nphylxs/fpga-guitar-pedal/docs/guitar-wiring-guide.png

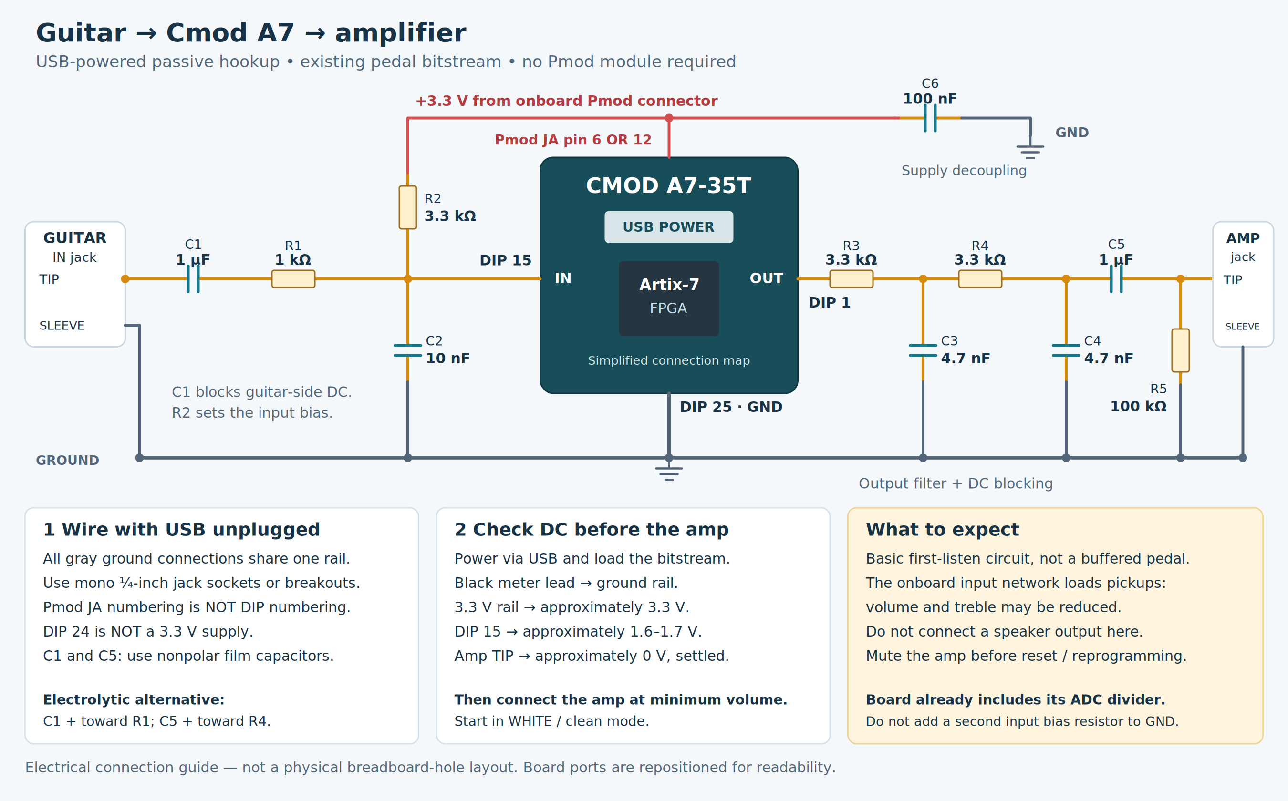
docs/guitar-wiring-guide.png
