nphylxs/fpga-guitar-pedal/docs/guitar-wiring-updated.png

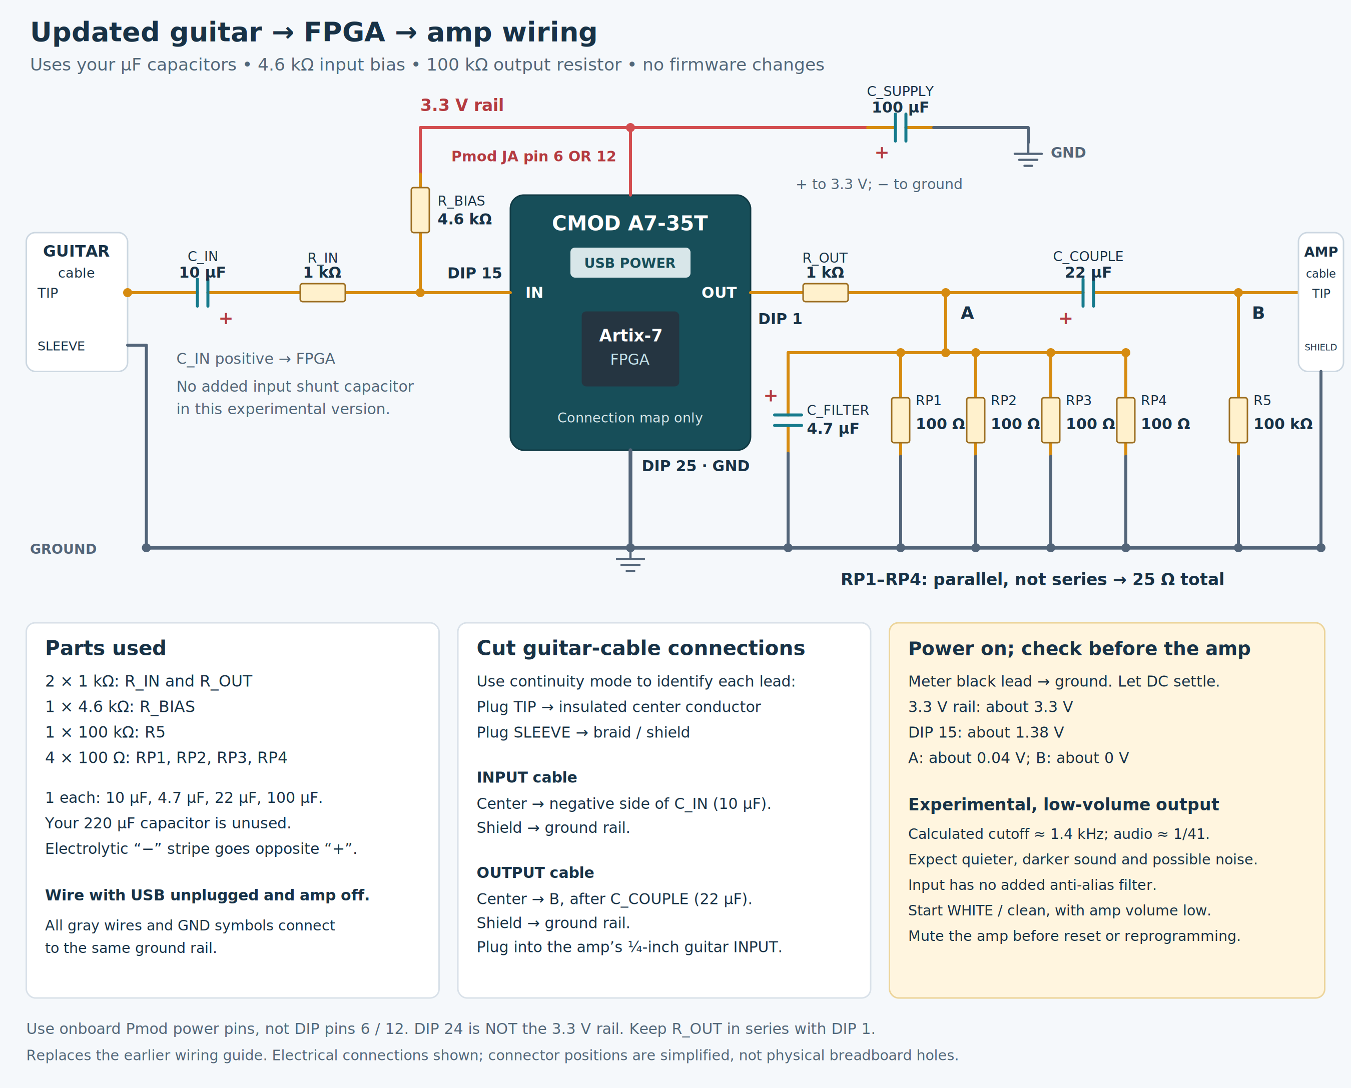
docs/guitar-wiring-updated.png
