nphylxs/fpga-guitar-pedal/rtl/fx_overdrive_asym.sv

module fx_overdrive_asym (
  input logic clk, rst, in_valid, enable,
  input logic signed [15:0] audio_in,
  input logic [7:0] drive,
  input logic [15:0] tone_alpha,
  output logic signed [15:0] audio_out,
  output logic out_valid
);
  import audio_math_pkg::*;
  function automatic logic signed [15:0] clip_lut(input logic [7:0] addr);
    case(addr)
      8'd0: clip_lut = 16'shc000;
      8'd1: clip_lut = 16'shc000;
      8'd2: clip_lut = 16'shc000;
      8'd3: clip_lut = 16'shc000;
      8'd4: clip_lut = 16'shc000;
      8'd5: clip_lut = 16'shc000;
      8'd6: clip_lut = 16'shc000;
      8'd7: clip_lut = 16'shc000;
      8'd8: clip_lut = 16'shc000;
      8'd9: clip_lut = 16'shc000;
      8'd10: clip_lut = 16'shc000;
      8'd11: clip_lut = 16'shc000;
      8'd12: clip_lut = 16'shc000;
      8'd13: clip_lut = 16'shc000;
      8'd14: clip_lut = 16'shc000;
      8'd15: clip_lut = 16'shc000;
      8'd16: clip_lut = 16'shc000;
      8'd17: clip_lut = 16'shc000;
      8'd18: clip_lut = 16'shc000;
      8'd19: clip_lut = 16'shc000;
      8'd20: clip_lut = 16'shc000;
      8'd21: clip_lut = 16'shc000;
      8'd22: clip_lut = 16'shc000;
      8'd23: clip_lut = 16'shc000;
      8'd24: clip_lut = 16'shc000;
      8'd25: clip_lut = 16'shc000;
      8'd26: clip_lut = 16'shc000;
      8'd27: clip_lut = 16'shc000;
      8'd28: clip_lut = 16'shc000;
      8'd29: clip_lut = 16'shc000;
      8'd30: clip_lut = 16'shc000;
      8'd31: clip_lut = 16'shc000;
      8'd32: clip_lut = 16'shc000;
      8'd33: clip_lut = 16'shc000;
      8'd34: clip_lut = 16'shc000;
      8'd35: clip_lut = 16'shc000;
      8'd36: clip_lut = 16'shc000;
      8'd37: clip_lut = 16'shc000;
      8'd38: clip_lut = 16'shc000;
      8'd39: clip_lut = 16'shc000;
      8'd40: clip_lut = 16'shc001;
      8'd41: clip_lut = 16'shc001;
      8'd42: clip_lut = 16'shc001;
      8'd43: clip_lut = 16'shc001;
      8'd44: clip_lut = 16'shc001;
      8'd45: clip_lut = 16'shc001;
      8'd46: clip_lut = 16'shc001;
      8'd47: clip_lut = 16'shc001;
      8'd48: clip_lut = 16'shc001;
      8'd49: clip_lut = 16'shc002;
      8'd50: clip_lut = 16'shc002;
      8'd51: clip_lut = 16'shc002;
      8'd52: clip_lut = 16'shc002;
      8'd53: clip_lut = 16'shc003;
      8'd54: clip_lut = 16'shc003;
      8'd55: clip_lut = 16'shc004;
      8'd56: clip_lut = 16'shc004;
      8'd57: clip_lut = 16'shc005;
      8'd58: clip_lut = 16'shc005;
      8'd59: clip_lut = 16'shc006;
      8'd60: clip_lut = 16'shc007;
      8'd61: clip_lut = 16'shc008;
      8'd62: clip_lut = 16'shc009;
      8'd63: clip_lut = 16'shc00a;
      8'd64: clip_lut = 16'shc00b;
      8'd65: clip_lut = 16'shc00c;
      8'd66: clip_lut = 16'shc00e;
      8'd67: clip_lut = 16'shc010;
      8'd68: clip_lut = 16'shc012;
      8'd69: clip_lut = 16'shc015;
      8'd70: clip_lut = 16'shc017;
      8'd71: clip_lut = 16'shc01a;
      8'd72: clip_lut = 16'shc01e;
      8'd73: clip_lut = 16'shc022;
      8'd74: clip_lut = 16'shc026;
      8'd75: clip_lut = 16'shc02b;
      8'd76: clip_lut = 16'shc031;
      8'd77: clip_lut = 16'shc038;
      8'd78: clip_lut = 16'shc03f;
      8'd79: clip_lut = 16'shc048;
      8'd80: clip_lut = 16'shc051;
      8'd81: clip_lut = 16'shc05c;
      8'd82: clip_lut = 16'shc068;
      8'd83: clip_lut = 16'shc076;
      8'd84: clip_lut = 16'shc085;
      8'd85: clip_lut = 16'shc097;
      8'd86: clip_lut = 16'shc0ab;
      8'd87: clip_lut = 16'shc0c2;
      8'd88: clip_lut = 16'shc0db;
      8'd89: clip_lut = 16'shc0f8;
      8'd90: clip_lut = 16'shc119;
      8'd91: clip_lut = 16'shc13e;
      8'd92: clip_lut = 16'shc168;
      8'd93: clip_lut = 16'shc197;
      8'd94: clip_lut = 16'shc1cd;
      8'd95: clip_lut = 16'shc209;
      8'd96: clip_lut = 16'shc24d;
      8'd97: clip_lut = 16'shc29a;
      8'd98: clip_lut = 16'shc2f1;
      8'd99: clip_lut = 16'shc353;
      8'd100: clip_lut = 16'shc3c1;
      8'd101: clip_lut = 16'shc43c;
      8'd102: clip_lut = 16'shc4c7;
      8'd103: clip_lut = 16'shc563;
      8'd104: clip_lut = 16'shc612;
      8'd105: clip_lut = 16'shc6d6;
      8'd106: clip_lut = 16'shc7b1;
      8'd107: clip_lut = 16'shc8a5;
      8'd108: clip_lut = 16'shc9b6;
      8'd109: clip_lut = 16'shcae5;
      8'd110: clip_lut = 16'shcc34;
      8'd111: clip_lut = 16'shcda8;
      8'd112: clip_lut = 16'shcf42;
      8'd113: clip_lut = 16'shd105;
      8'd114: clip_lut = 16'shd2f3;
      8'd115: clip_lut = 16'shd50f;
      8'd116: clip_lut = 16'shd75a;
      8'd117: clip_lut = 16'shd9d5;
      8'd118: clip_lut = 16'shdc81;
      8'd119: clip_lut = 16'shdf5f;
      8'd120: clip_lut = 16'she26d;
      8'd121: clip_lut = 16'she5a9;
      8'd122: clip_lut = 16'she911;
      8'd123: clip_lut = 16'sheca0;
      8'd124: clip_lut = 16'shf053;
      8'd125: clip_lut = 16'shf424;
      8'd126: clip_lut = 16'shf80b;
      8'd127: clip_lut = 16'shfc01;
      8'd128: clip_lut = 16'sh0000;
      8'd129: clip_lut = 16'sh03ff;
      8'd130: clip_lut = 16'sh07fb;
      8'd131: clip_lut = 16'sh0bf0;
      8'd132: clip_lut = 16'sh0fda;
      8'd133: clip_lut = 16'sh13b7;
      8'd134: clip_lut = 16'sh1783;
      8'd135: clip_lut = 16'sh1b3b;
      8'd136: clip_lut = 16'sh1edd;
      8'd137: clip_lut = 16'sh2267;
      8'd138: clip_lut = 16'sh25d6;
      8'd139: clip_lut = 16'sh2928;
      8'd140: clip_lut = 16'sh2c5d;
      8'd141: clip_lut = 16'sh2f73;
      8'd142: clip_lut = 16'sh3268;
      8'd143: clip_lut = 16'sh353e;
      8'd144: clip_lut = 16'sh37f2;
      8'd145: clip_lut = 16'sh3a86;
      8'd146: clip_lut = 16'sh3cf9;
      8'd147: clip_lut = 16'sh3f4c;
      8'd148: clip_lut = 16'sh417f;
      8'd149: clip_lut = 16'sh4393;
      8'd150: clip_lut = 16'sh4589;
      8'd151: clip_lut = 16'sh4761;
      8'd152: clip_lut = 16'sh491d;
      8'd153: clip_lut = 16'sh4abe;
      8'd154: clip_lut = 16'sh4c44;
      8'd155: clip_lut = 16'sh4db1;
      8'd156: clip_lut = 16'sh4f07;
      8'd157: clip_lut = 16'sh5046;
      8'd158: clip_lut = 16'sh516f;
      8'd159: clip_lut = 16'sh5285;
      8'd160: clip_lut = 16'sh5387;
      8'd161: clip_lut = 16'sh5477;
      8'd162: clip_lut = 16'sh5556;
      8'd163: clip_lut = 16'sh5625;
      8'd164: clip_lut = 16'sh56e5;
      8'd165: clip_lut = 16'sh5797;
      8'd166: clip_lut = 16'sh583c;
      8'd167: clip_lut = 16'sh58d5;
      8'd168: clip_lut = 16'sh5963;
      8'd169: clip_lut = 16'sh59e6;
      8'd170: clip_lut = 16'sh5a5f;
      8'd171: clip_lut = 16'sh5acf;
      8'd172: clip_lut = 16'sh5b37;
      8'd173: clip_lut = 16'sh5b97;
      8'd174: clip_lut = 16'sh5bef;
      8'd175: clip_lut = 16'sh5c41;
      8'd176: clip_lut = 16'sh5c8c;
      8'd177: clip_lut = 16'sh5cd1;
      8'd178: clip_lut = 16'sh5d12;
      8'd179: clip_lut = 16'sh5d4d;
      8'd180: clip_lut = 16'sh5d83;
      8'd181: clip_lut = 16'sh5db6;
      8'd182: clip_lut = 16'sh5de4;
      8'd183: clip_lut = 16'sh5e0f;
      8'd184: clip_lut = 16'sh5e36;
      8'd185: clip_lut = 16'sh5e5a;
      8'd186: clip_lut = 16'sh5e7c;
      8'd187: clip_lut = 16'sh5e9b;
      8'd188: clip_lut = 16'sh5eb7;
      8'd189: clip_lut = 16'sh5ed1;
      8'd190: clip_lut = 16'sh5ee9;
      8'd191: clip_lut = 16'sh5eff;
      8'd192: clip_lut = 16'sh5f14;
      8'd193: clip_lut = 16'sh5f27;
      8'd194: clip_lut = 16'sh5f38;
      8'd195: clip_lut = 16'sh5f48;
      8'd196: clip_lut = 16'sh5f57;
      8'd197: clip_lut = 16'sh5f64;
      8'd198: clip_lut = 16'sh5f70;
      8'd199: clip_lut = 16'sh5f7c;
      8'd200: clip_lut = 16'sh5f86;
      8'd201: clip_lut = 16'sh5f90;
      8'd202: clip_lut = 16'sh5f99;
      8'd203: clip_lut = 16'sh5fa1;
      8'd204: clip_lut = 16'sh5fa9;
      8'd205: clip_lut = 16'sh5fb0;
      8'd206: clip_lut = 16'sh5fb6;
      8'd207: clip_lut = 16'sh5fbc;
      8'd208: clip_lut = 16'sh5fc2;
      8'd209: clip_lut = 16'sh5fc7;
      8'd210: clip_lut = 16'sh5fcb;
      8'd211: clip_lut = 16'sh5fcf;
      8'd212: clip_lut = 16'sh5fd3;
      8'd213: clip_lut = 16'sh5fd7;
      8'd214: clip_lut = 16'sh5fda;
      8'd215: clip_lut = 16'sh5fdd;
      8'd216: clip_lut = 16'sh5fe0;
      8'd217: clip_lut = 16'sh5fe2;
      8'd218: clip_lut = 16'sh5fe5;
      8'd219: clip_lut = 16'sh5fe7;
      8'd220: clip_lut = 16'sh5fe9;
      8'd221: clip_lut = 16'sh5feb;
      8'd222: clip_lut = 16'sh5fed;
      8'd223: clip_lut = 16'sh5fee;
      8'd224: clip_lut = 16'sh5ff0;
      8'd225: clip_lut = 16'sh5ff1;
      8'd226: clip_lut = 16'sh5ff2;
      8'd227: clip_lut = 16'sh5ff3;
      8'd228: clip_lut = 16'sh5ff4;
      8'd229: clip_lut = 16'sh5ff5;
      8'd230: clip_lut = 16'sh5ff6;
      8'd231: clip_lut = 16'sh5ff7;
      8'd232: clip_lut = 16'sh5ff8;
      8'd233: clip_lut = 16'sh5ff8;
      8'd234: clip_lut = 16'sh5ff9;
      8'd235: clip_lut = 16'sh5ff9;
      8'd236: clip_lut = 16'sh5ffa;
      8'd237: clip_lut = 16'sh5ffa;
      8'd238: clip_lut = 16'sh5ffb;
      8'd239: clip_lut = 16'sh5ffb;
      8'd240: clip_lut = 16'sh5ffc;
      8'd241: clip_lut = 16'sh5ffc;
      8'd242: clip_lut = 16'sh5ffc;
      8'd243: clip_lut = 16'sh5ffd;
      8'd244: clip_lut = 16'sh5ffd;
      8'd245: clip_lut = 16'sh5ffd;
      8'd246: clip_lut = 16'sh5ffd;
      8'd247: clip_lut = 16'sh5ffe;
      8'd248: clip_lut = 16'sh5ffe;
      8'd249: clip_lut = 16'sh5ffe;
      8'd250: clip_lut = 16'sh5ffe;
      8'd251: clip_lut = 16'sh5ffe;
      8'd252: clip_lut = 16'sh5ffe;
      8'd253: clip_lut = 16'sh5fff;
      8'd254: clip_lut = 16'sh5fff;
      8'd255: clip_lut = 16'sh5fff;
    endcase
  endfunction
  logic [3:0] state;
  logic active;
  logic signed [15:0] dry;
  logic [15:0] alpha;
  logic signed [31:0] gained, target, tone_q8, delta;
  logic signed [48:0] product;
  logic signed [48:0] next_tone;
  logic [7:0] index;
  logic signed [15:0] clip_a;
  logic signed [16:0] clip_delta;
  logic [9:0] fraction;
  logic signed [27:0] clip_product;
  always_comb begin
    if (gained >= 131071) index=255;
    else if (gained < -131072) index=0;
    else index=8'((gained >>> 10)+128);
    delta=target-tone_q8;
    next_tone=49'(tone_q8)+(product >>> 16);
  end
  always_ff @(posedge clk) begin
    if (rst) begin
      state<=0; audio_out<=0; out_valid<=0; tone_q8<=0;
      gained<=0; target<=0; product<=0; dry<=0; active<=0; alpha<=0; clip_a<=0; clip_delta<=0; fraction<=0; clip_product<=0;
    end else begin
      out_valid<=0;
      case(state)
        0: if(in_valid) begin
          dry<=audio_in; active<=enable; alpha<=tone_alpha;
          gained<=($signed(audio_in)*$signed({1'b0,drive}+10'd16)) >>> 4;
          state<=1;
        end
        1: begin
          clip_a<=clip_lut(index);
          clip_delta<=17'(clip_lut(index==255?index:index+1'b1))-17'(clip_lut(index));
          fraction<=(gained < -131072 || gained >= 130048)?10'd0:gained[9:0];
          state<=2;
        end
        2: begin clip_product<=clip_delta*$signed({1'b0,fraction}); state<=3; end
        3: begin target<=(32'(clip_a) <<< 8)+(32'(clip_product) >>> 2); state<=4; end
        4: begin product<=delta*$signed({1'b0,alpha}); state<=5; end
        5: begin
          tone_q8<=next_tone[31:0];
          audio_out<=active ? sat16(48'(next_tone >>> 8)) : dry;
          out_valid<=1; state<=0;
        end
        default: state<=0;
      endcase
    end
  end
endmodule
